M5Ross/AccDec_8Servos_LN_USB/pcb/pcb.png

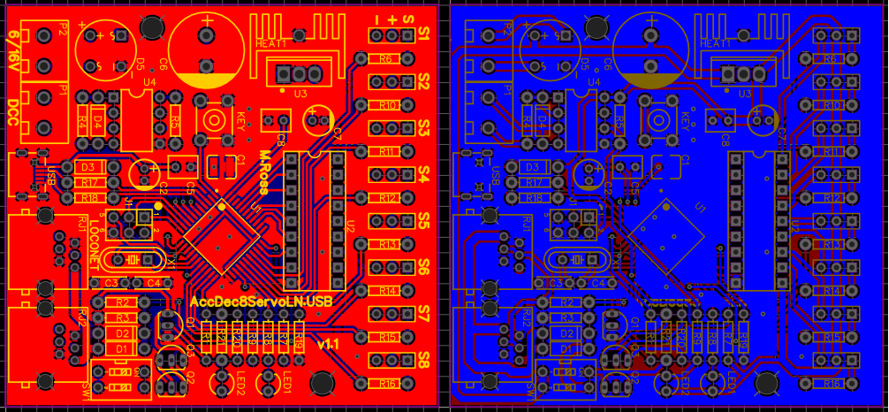
pcb/pcb.png
