M5Ross/AccDec_8Servos_LN_USB/pcb/BOM_PCB_AccDec8ServoUSB_v1_1.csv

ID | Name | Designator | Footprint | Quantity | Manufacturer Part | Manufacturer | Supplier | Supplier Part | Price
1 | 10k | R21,R7,R5,R1 | AXIAL-0.3 | 4
2 | VDG/S-02L | SW1 | SW-TH_VDG-S-02L | 1
3 | DS1133-S60APS | RJ2,RJ1 | RJ11-TH_6PIN_DS1133-S60APS | 2
4 | BC547B Tube | Q3,Q2,Q1 | TO-92(TO-92-3) | 3
5 | 47 | R20 | AXIAL-0.3 | 1
6 | 1k | R19,R8,R15,R14,R13,R12,R4,R11,R10,R6,R9,R16 | AXIAL-0.3 | 12
7 | WJ126V-5.0-2P | P2,P1 | WJ126V-5.0-2P | 2
8 | 2W10 | D5 | BRIDGE-WOB | 1
9 | 15*10.5*21 | HEAT1 | 15*10.5*21 | 1
10 | ATMEGA32U4-AU | U1 | QFP-44_10X10X08P | 1
11 | 7805 | U3 | TO-220-3_L10.0-W4.5-P2.54-L | 1
12 | CON_HEADER_PRG_AVR_ICSP-PTH | J1 | HEADER_PRG_2X03 | 1
13 | ULN2803G-D18-T | U2 | DIP-18 | 1
14 | 22pF | C3,C4 | CAP-HV-5.5*2.0 | 2
15 | MICRO 4P DIP | USB | MINI-USB-SMD_MICRO-4P-DIP | 1
16 | TS-1102-5016 | KEY | KEY-6.0*6.0-2 | 1
17 | 47k | R3 | AXIAL-0.3 | 1
18 | 100k | R2 | AXIAL-0.3 | 1
19 | 22 | R17,R18 | AXIAL-0.3 | 2
20 | 1N4148 | D4,D3,D1,D2 | DO-35 | 4
21 | HDR-F-2.54_1x3 | H6,H7,H8,H1,H2,H3,H4,H5 | HDR-F-2.54_1X3 | 8
22 | 1uF | C1 | CAP_1210 | 1
23 | 1000uF | C6 | CAP-D12.5XF5.0 | 1
24 | 6N136 | U4 | DIP-8 | 1
25 | LED-3MM | LED2,LED1 | LED-3MM/2.54 | 2
26 | 100nF(104) | C8,C5 | CAP-CT4G-0805-2.54MM | 2
27 | 16MHz | X1 | HC-49S | 1
28 | 10uF | C7 | CAP-D5.0XF2.0 | 1
29 | 47uF | C2 | CAP-D5.0XF2.0 | 1
