M5Ross/AccDec_8Servos_LN_USB/sch/Schematic_AccDec8ServoLN-USB.pdf

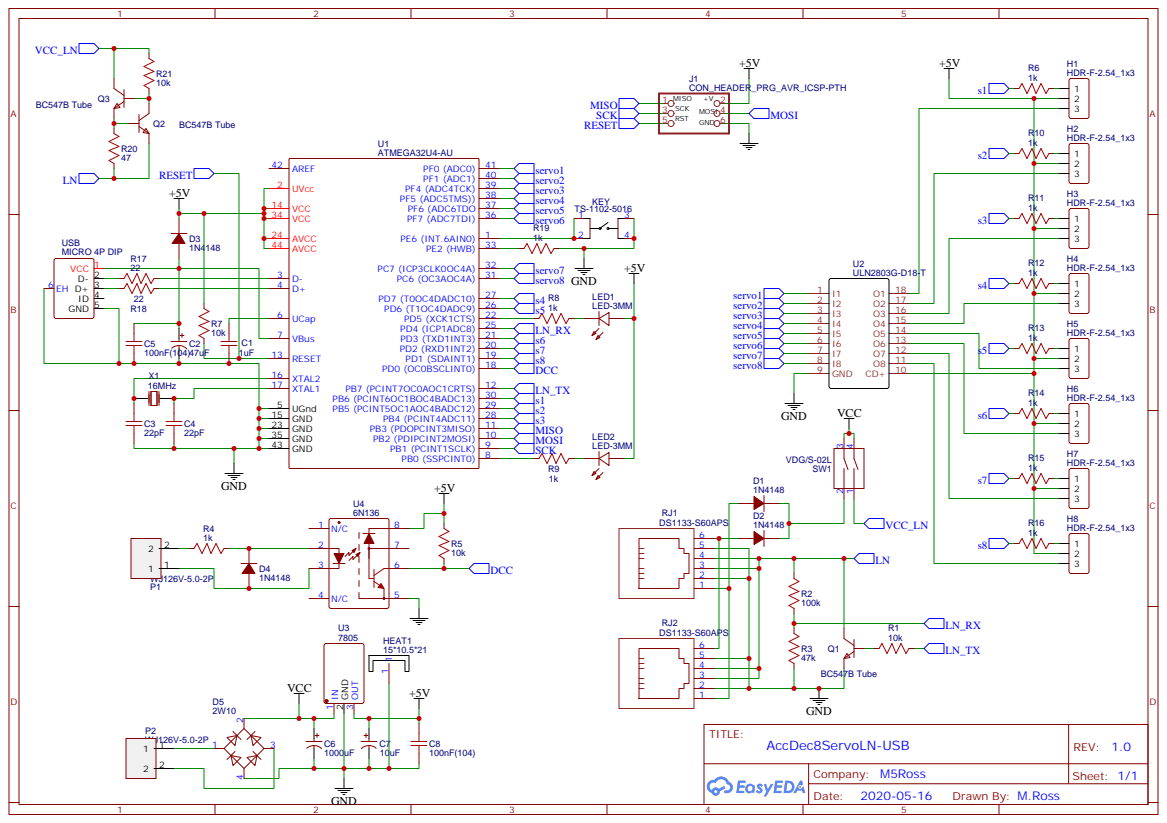
[picture p2: page 1]
