M5Ross/AccDec_8Servos_LN_USB/(commit log)

2022-12-04 Add pcb, schematic, gerber
    [BOM_PCB_AccDec8ServoUSB_v1_1.csv]
2023-11-18 Added DCC to LN gateway for switch requests
